kdarnok/lwz180/images/display.png

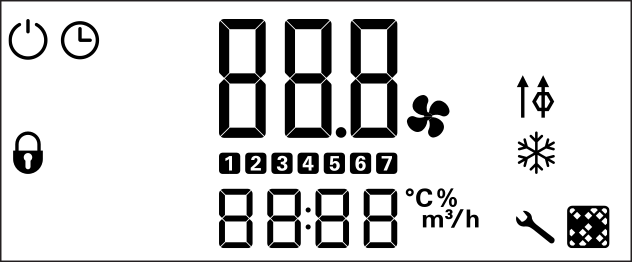
images/display.png
