kdarnok/lwz180/(commit log)

2023-01-29 [docs] first pass at documentation of the i2c based protocol
2023-01-29 [sketch] added the arduino sketch
2023-02-08 [docs] added pre-heater measurement
